Ghinescu-Lucian/Licenta/Imagini/MPU6050_schematics.png

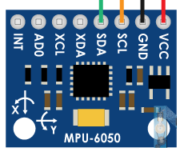
Imagini/MPU6050_schematics.png
