Ghinescu-Lucian/Licenta/Imagini/Testare_Fin.png

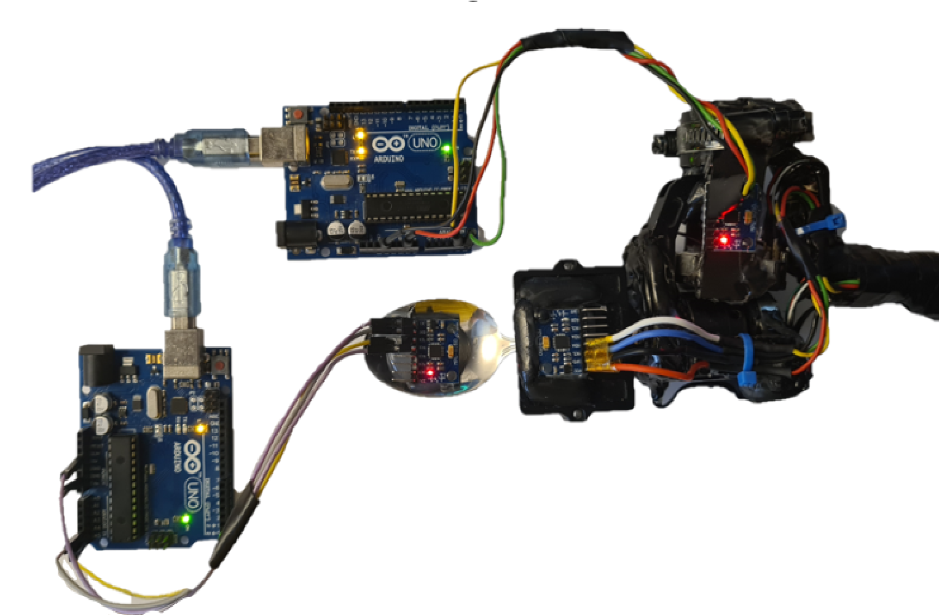
Imagini/Testare_Fin.png
