Ghinescu-Lucian/Licenta/Scheme/Scheme SimpleFOC.docx

12V

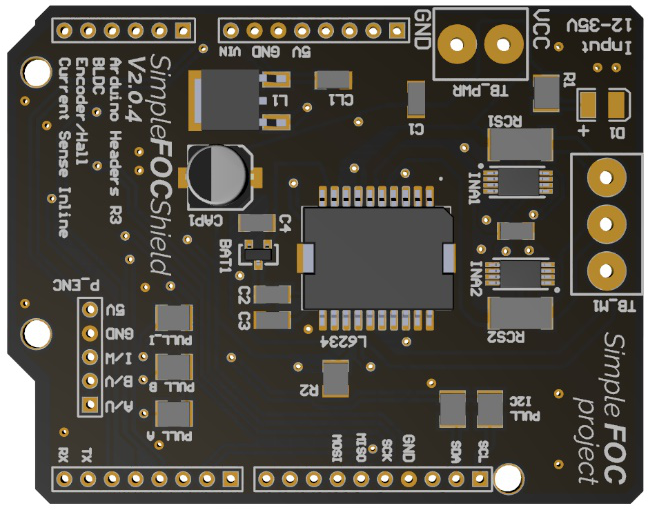
[picture p3: figure]
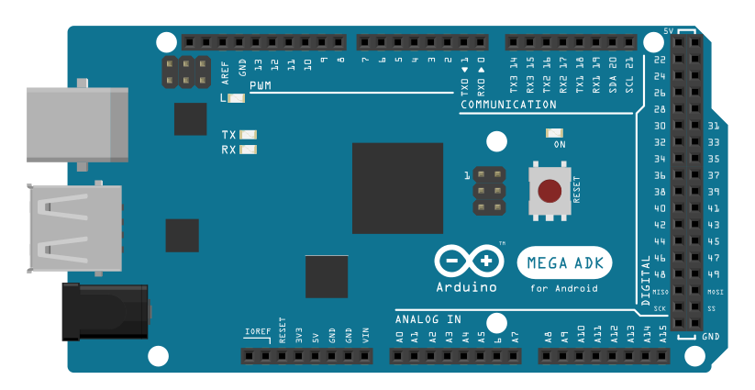
[picture p4: figure]

L1

L2

L3

L1 L2 L3

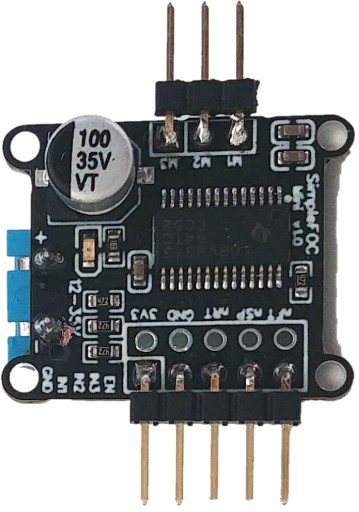
[picture p5: figure]

12V

GND P1 P2 P3 EN
