Ghinescu-Lucian/Licenta/Arduino/Metoda ziegler.docx

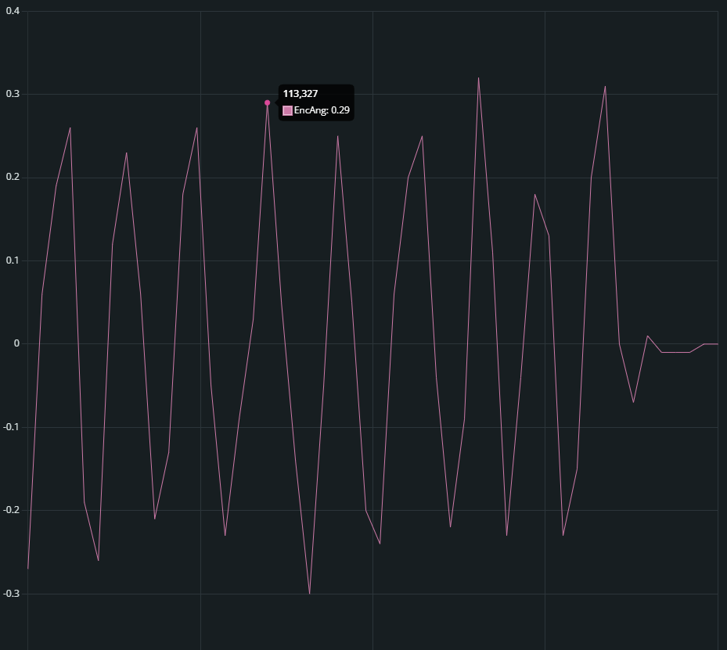
[picture p59: figure]
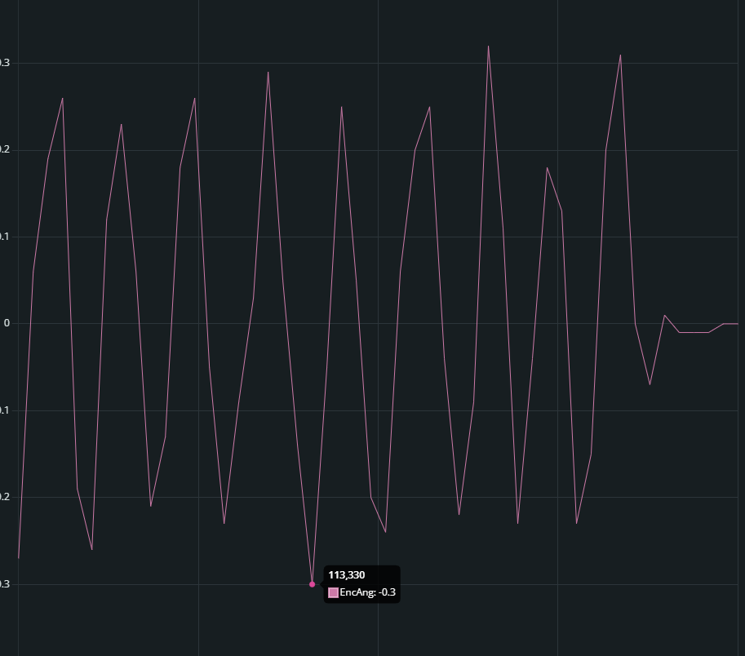
[picture p60: figure]
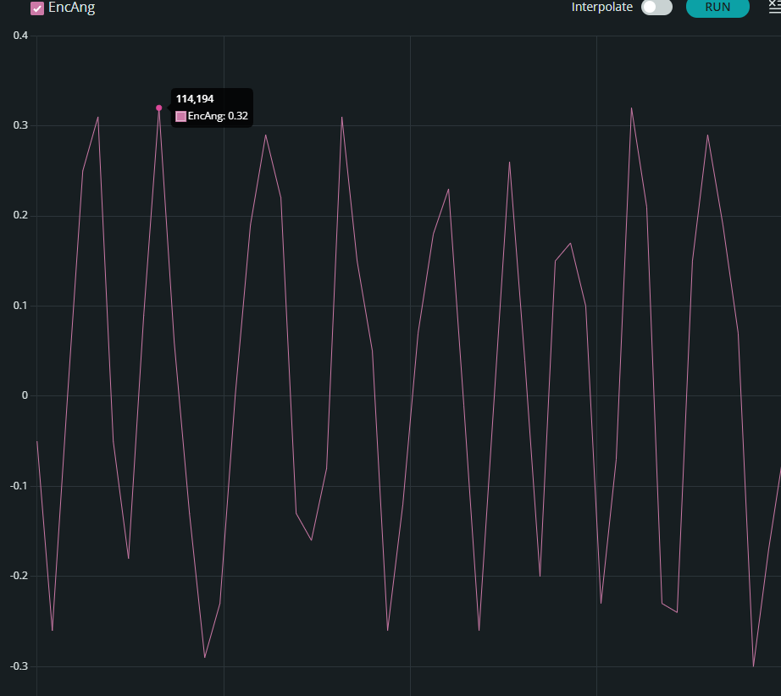
[picture p61: figure]
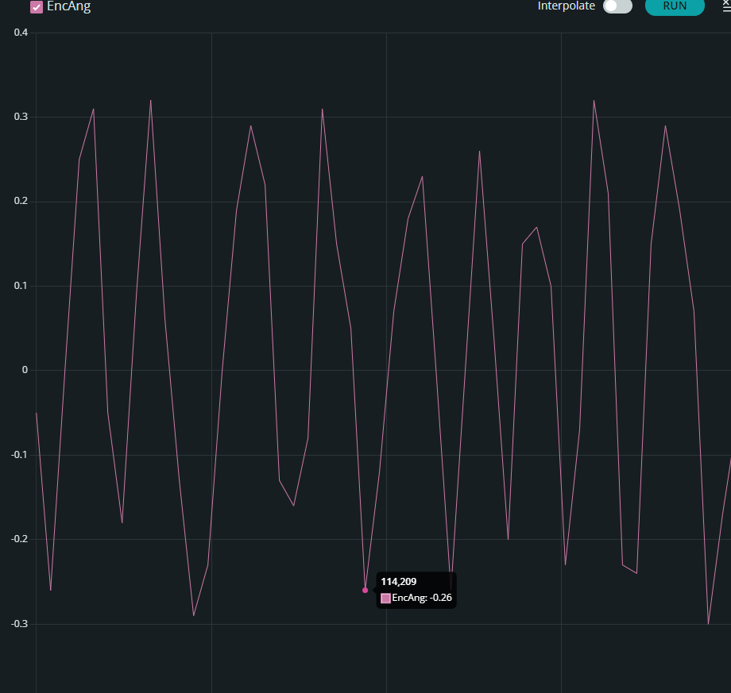
[picture p62: figure]

z

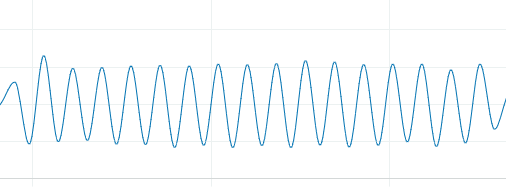
[picture p63: figure]
