Ghinescu-Lucian/Licenta/Arduino/Eroare calcul unghi Motor 1.docx

Eroare calcul unghi

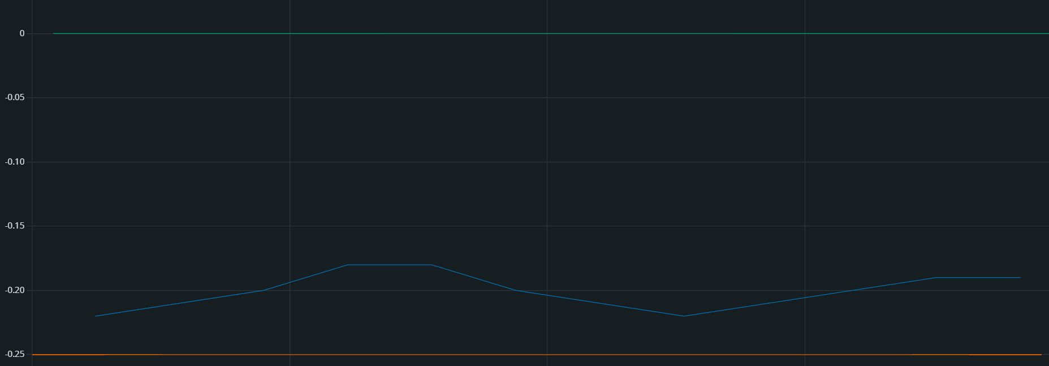
[picture p64: figure]
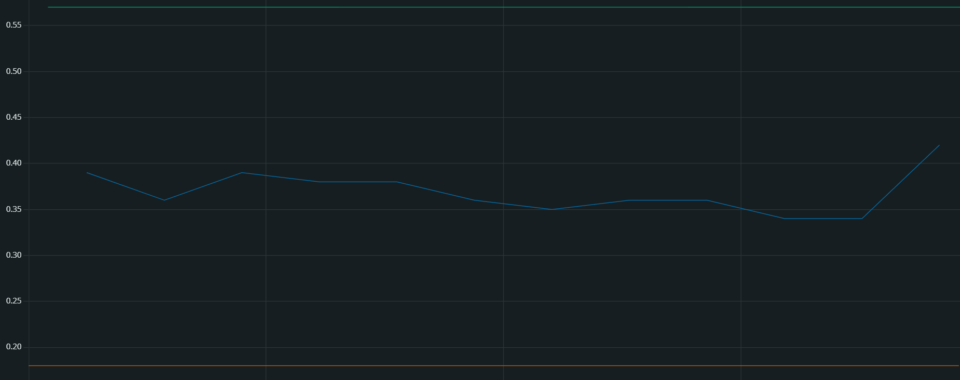
[picture p65: figure]
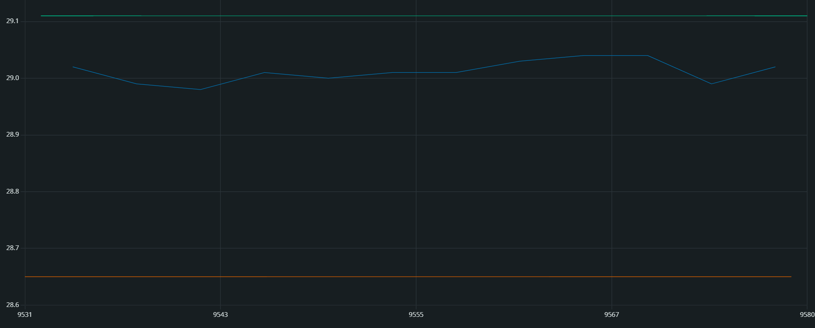
[picture p66: figure]
