Ghinescu-Lucian/Licenta/Arduino/ScreenShots.docx

GetAllData

Orizontal:

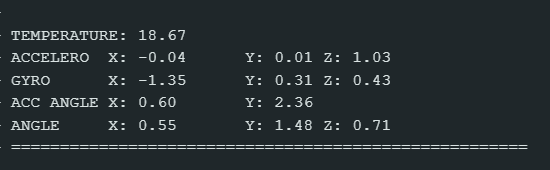
[picture p67: figure]
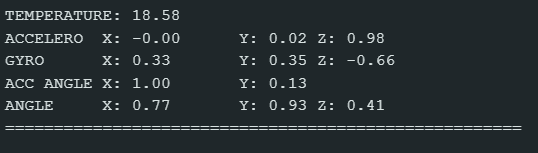
[picture p68: figure]
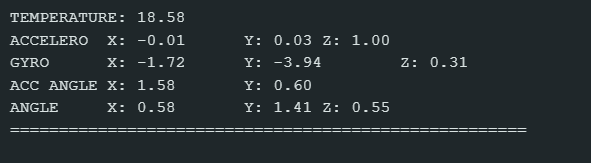
[picture p69: figure]
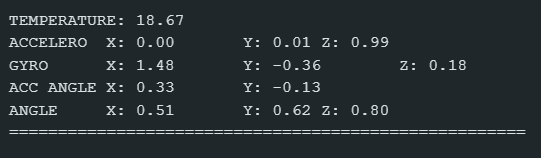
[picture p70: figure]

Rotit pozitiv pe Ox:
