Ghinescu-Lucian/Licenta/Arduino/SS2.docx

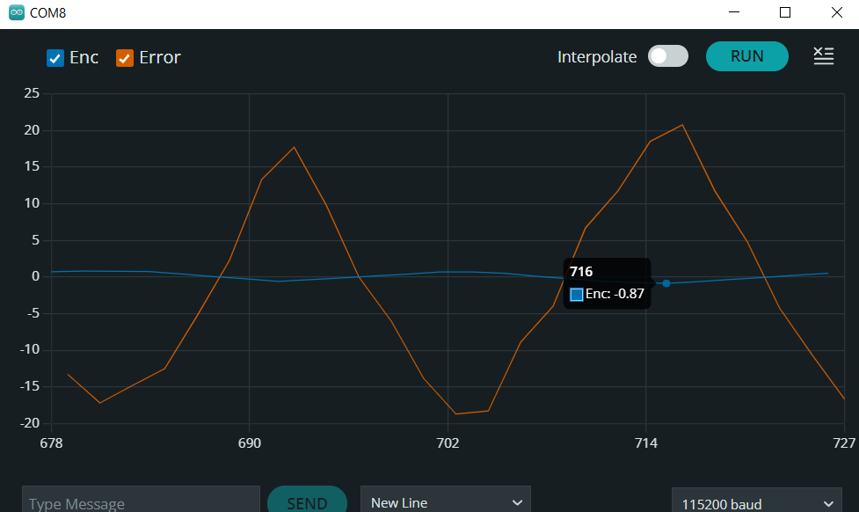
[picture p71: figure]
