Ghinescu-Lucian/Licenta/Imagini/20230531_155205.jpg

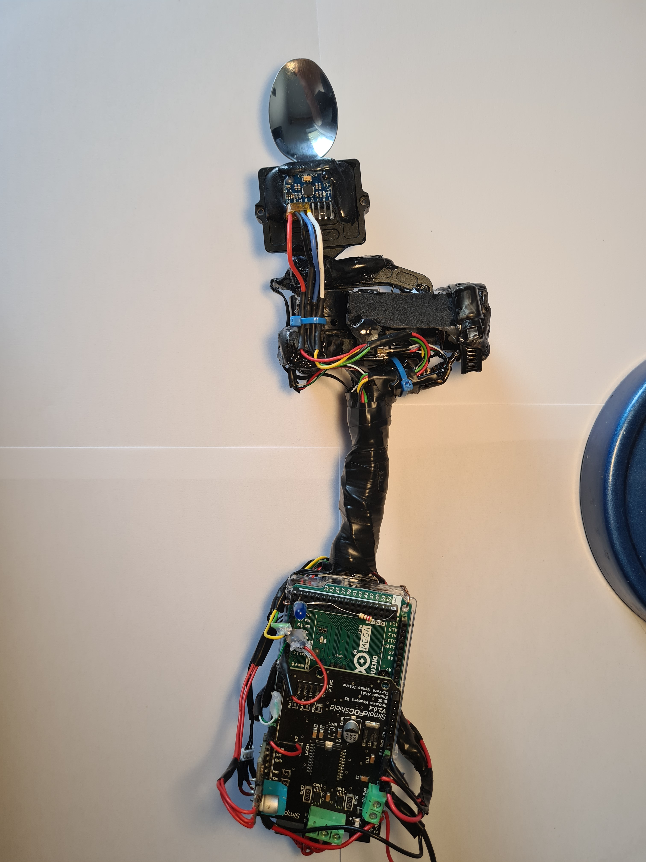
Imagini/20230531_155205.jpg
