Ghinescu-Lucian/Licenta/Imagini/20230531_160016.jpg

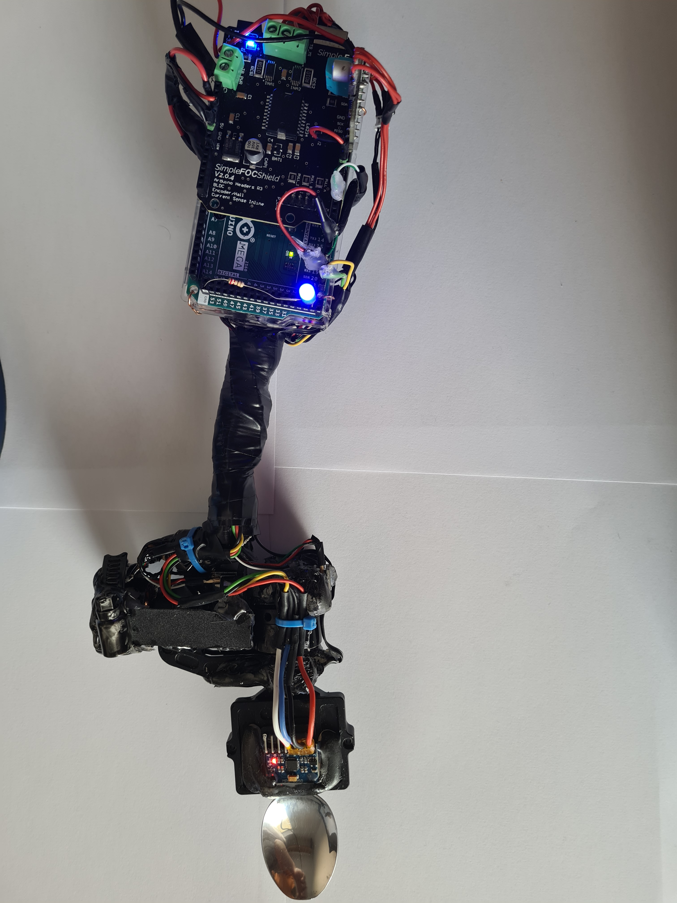
Imagini/20230531_160016.jpg
