Ghinescu-Lucian/Licenta/Imagini/20230531_160238.jpg

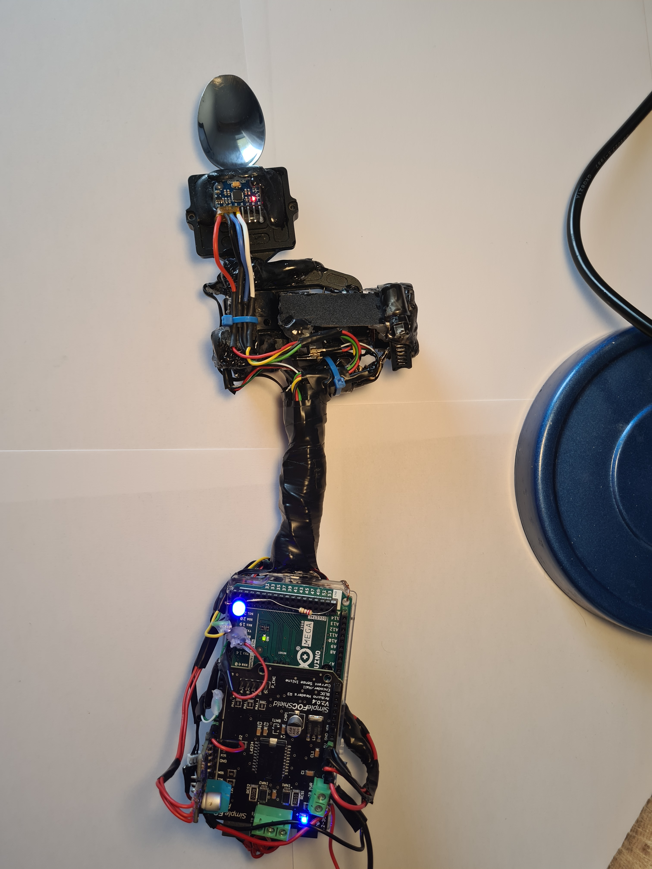
Imagini/20230531_160238.jpg
