Ghinescu-Lucian/Licenta/Imagini/20230531_161017.jpg

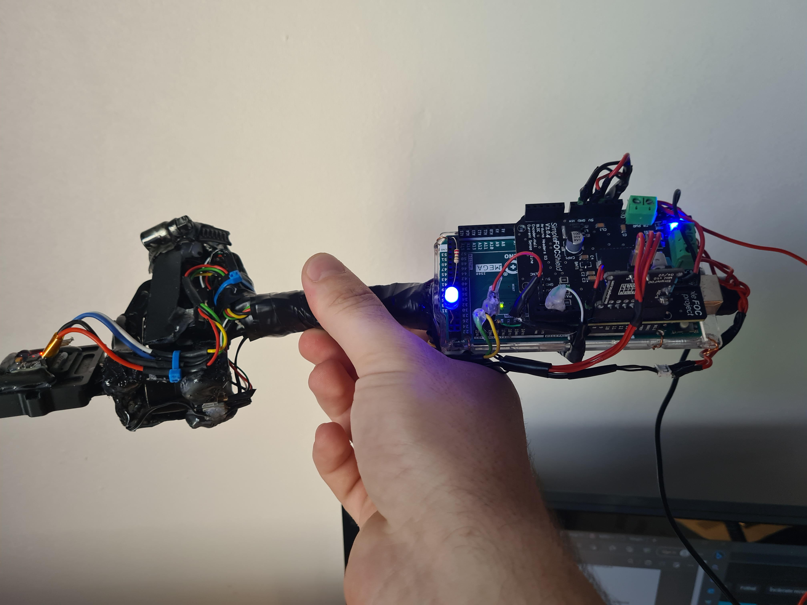
Imagini/20230531_161017.jpg
