Ghinescu-Lucian/Licenta/Imagini/20230531_161514.jpg

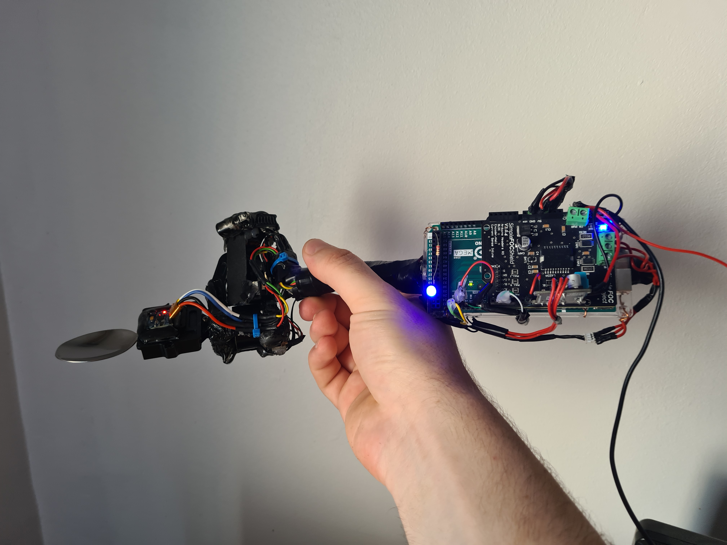
Imagini/20230531_161514.jpg
