Ghinescu-Lucian/Licenta/Imagini/20230611_162131.jpg

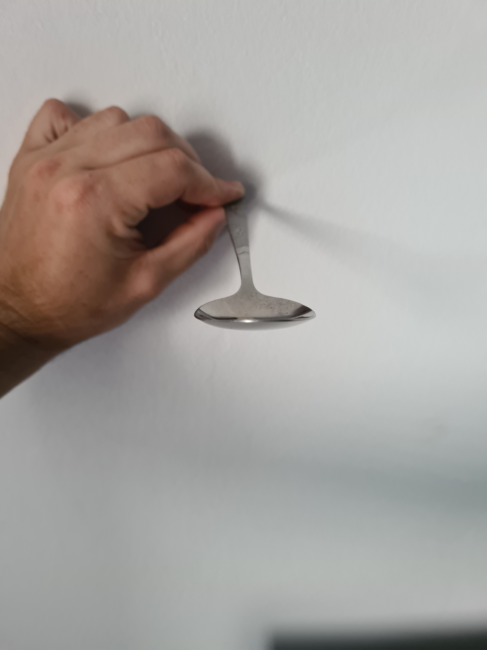
Imagini/20230611_162131.jpg
