Ghinescu-Lucian/Licenta/Imagini/20230611_182041.jpg

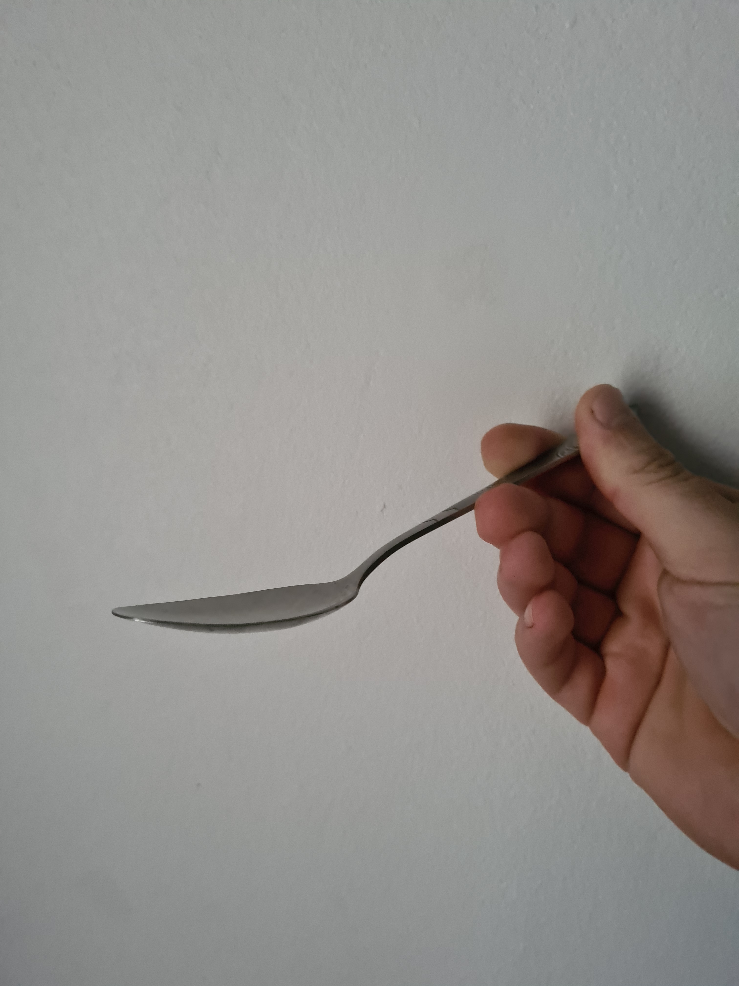
Imagini/20230611_182041.jpg
