Ghinescu-Lucian/Licenta/Imagini/20230612_202844.jpg

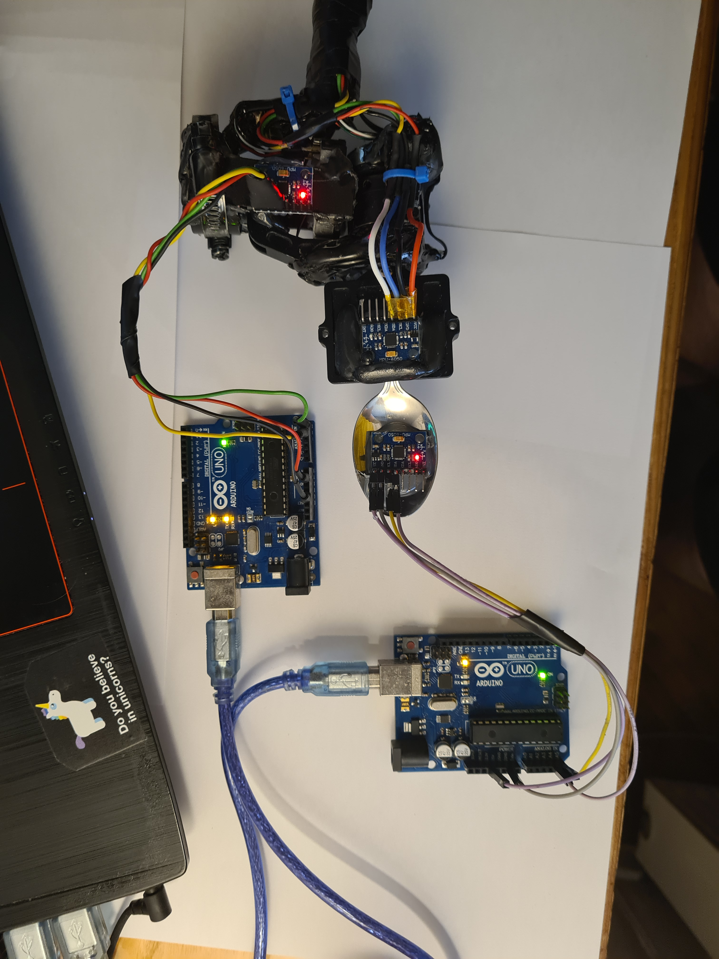
Imagini/20230612_202844.jpg
