Ghinescu-Lucian/Licenta/Imagini/amt103_PNG.png

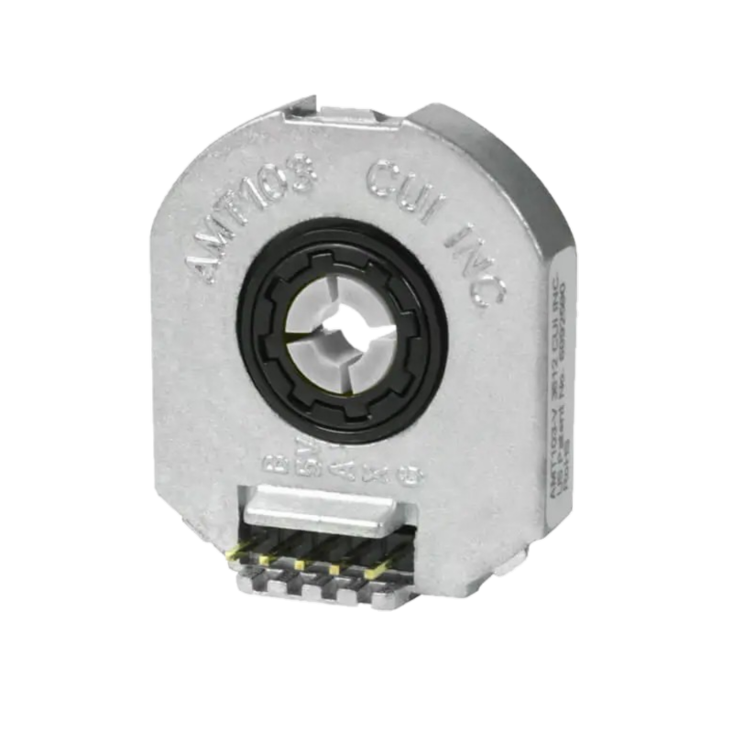
Imagini/amt103_PNG.png
