Ghinescu-Lucian/Licenta/Imagini/AMT303-V.jpg

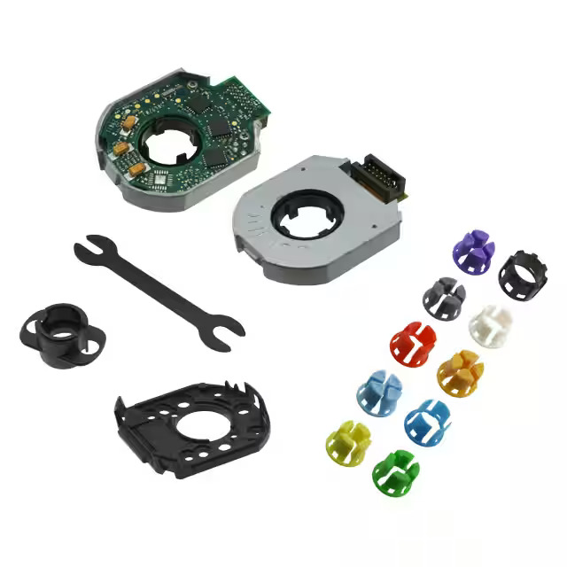
Imagini/AMT303-V.jpg
