Ghinescu-Lucian/Licenta/Imagini/arduino-mega-pin.png

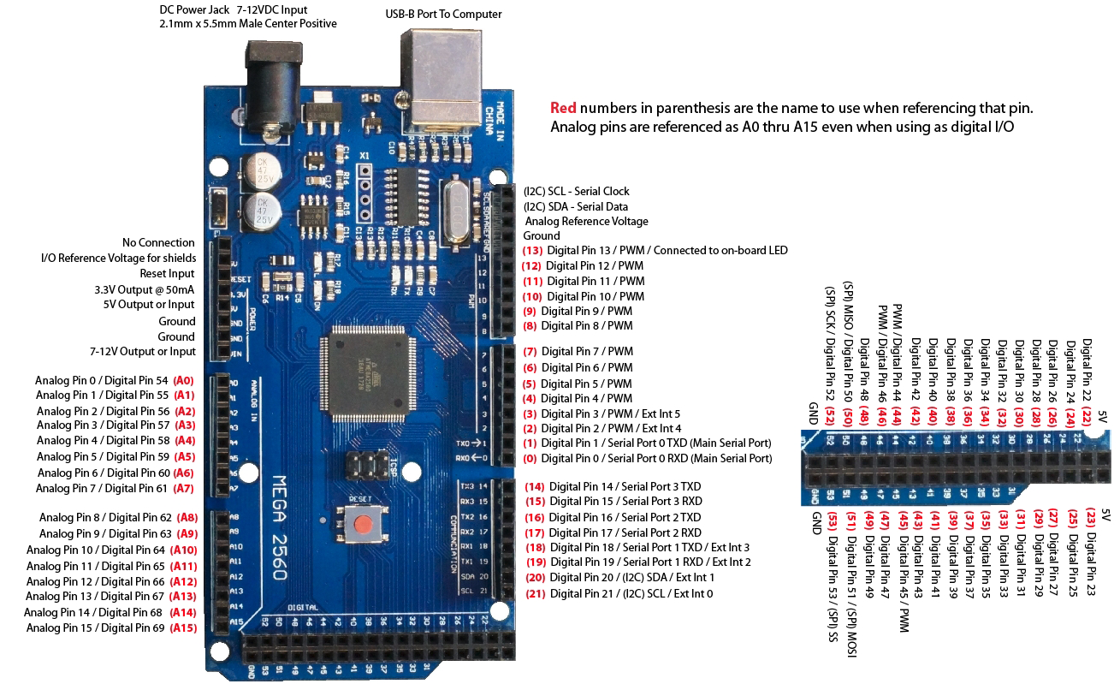
Imagini/arduino-mega-pin.png
