Ghinescu-Lucian/Licenta/Imagini/Axe.png

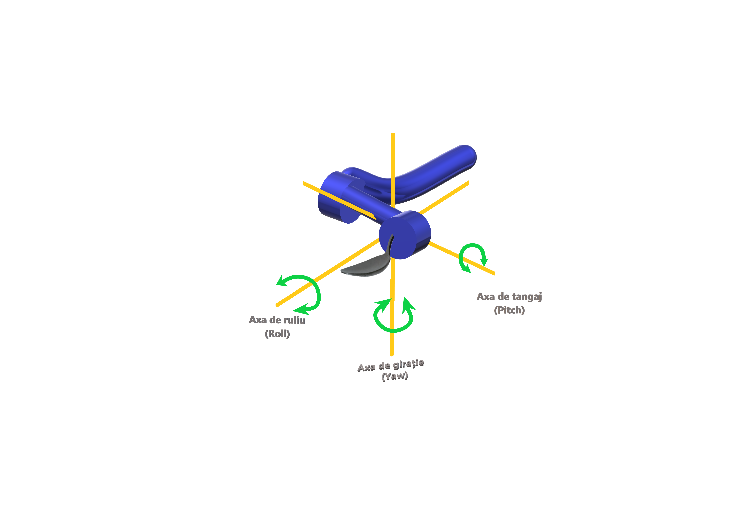
Imagini/Axe.png
