Ghinescu-Lucian/Licenta/Imagini/chip.png

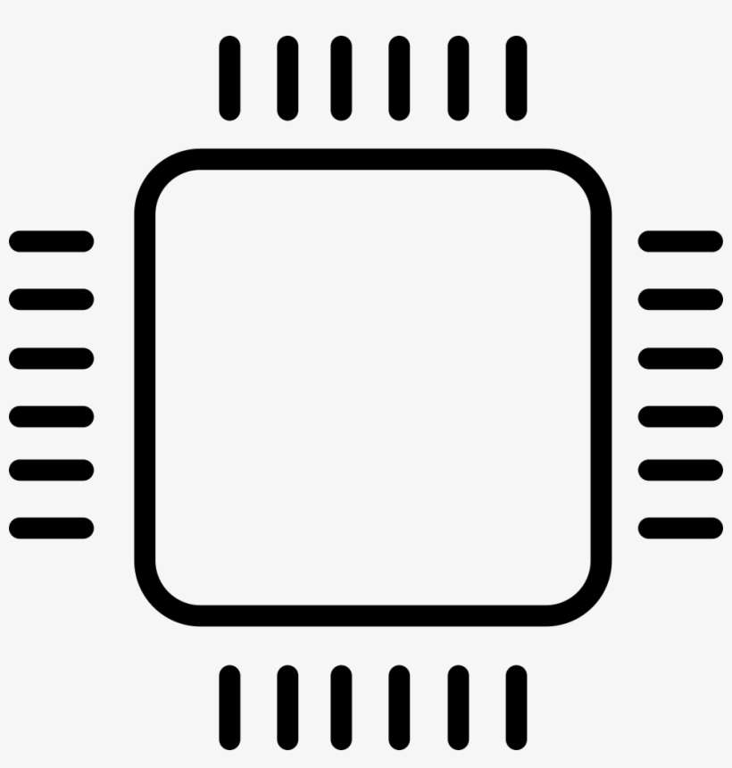
Imagini/chip.png
