Ghinescu-Lucian/Licenta/Imagini/chipArduino.png

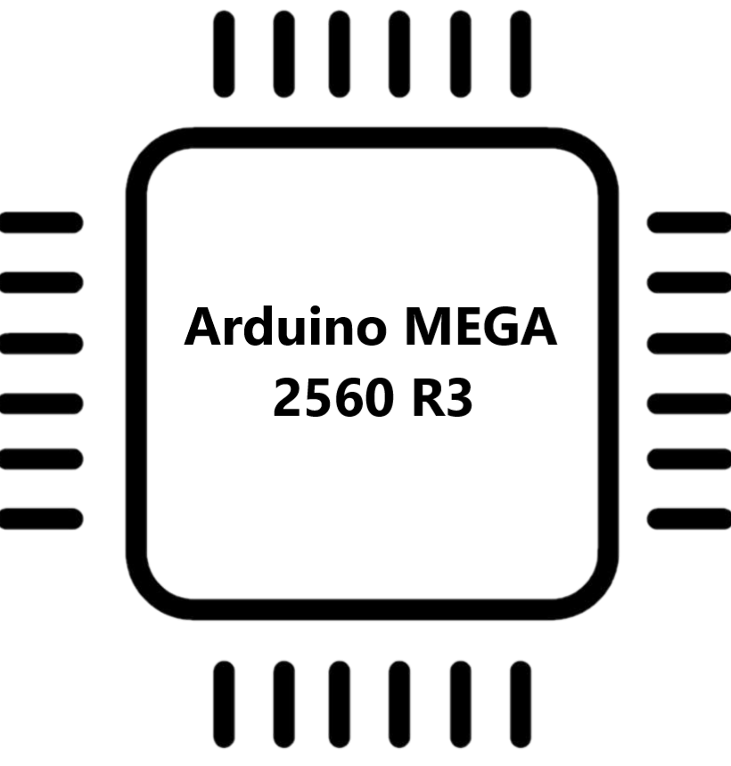
Imagini/chipArduino.png
