Ghinescu-Lucian/Licenta/Imagini/CUI_AMT103.jpg

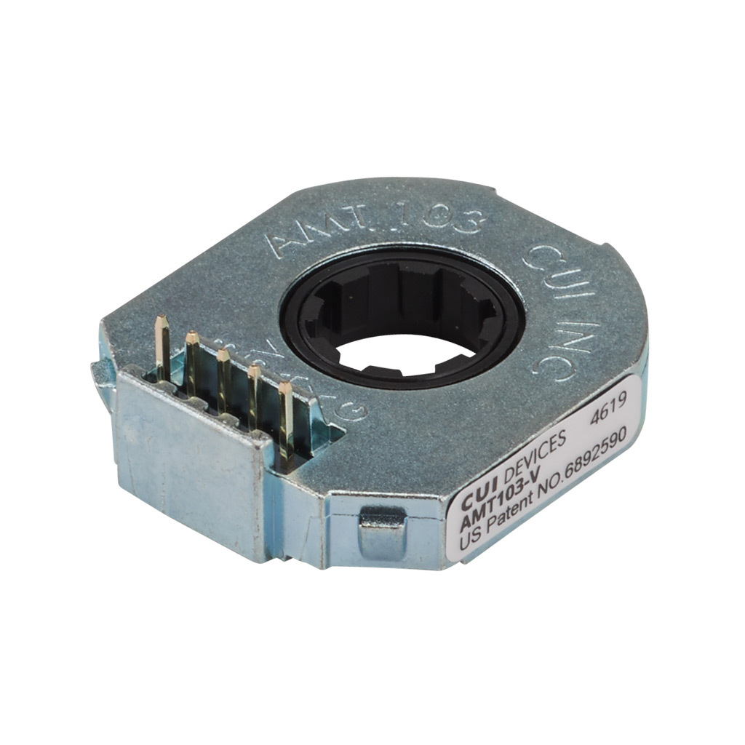
Imagini/CUI_AMT103.jpg
