Ghinescu-Lucian/Licenta/Imagini/driverFOC_PNG.png

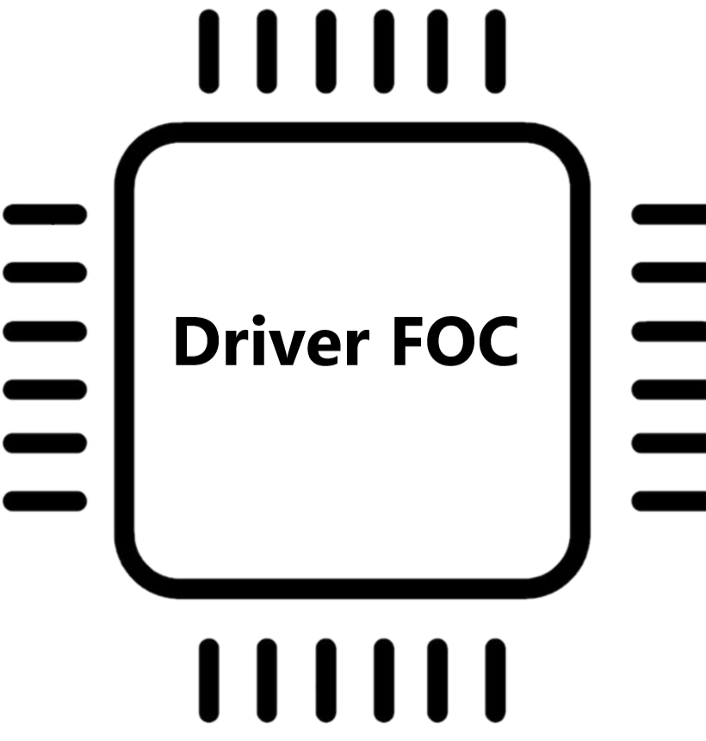
Imagini/driverFOC_PNG.png
