Ghinescu-Lucian/Licenta/Imagini/Licenta profil.png

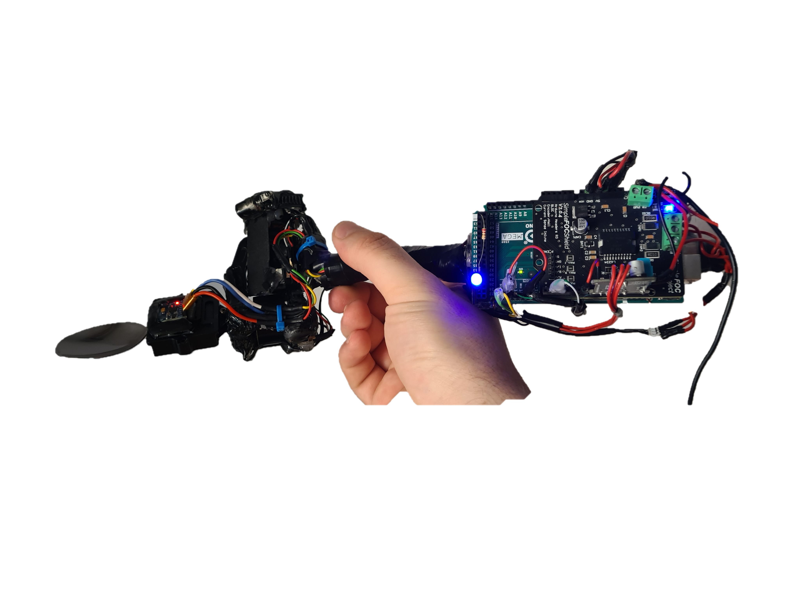
Imagini/Licenta profil.png
