Ghinescu-Lucian/Licenta/Imagini/Licenta_Sus.png

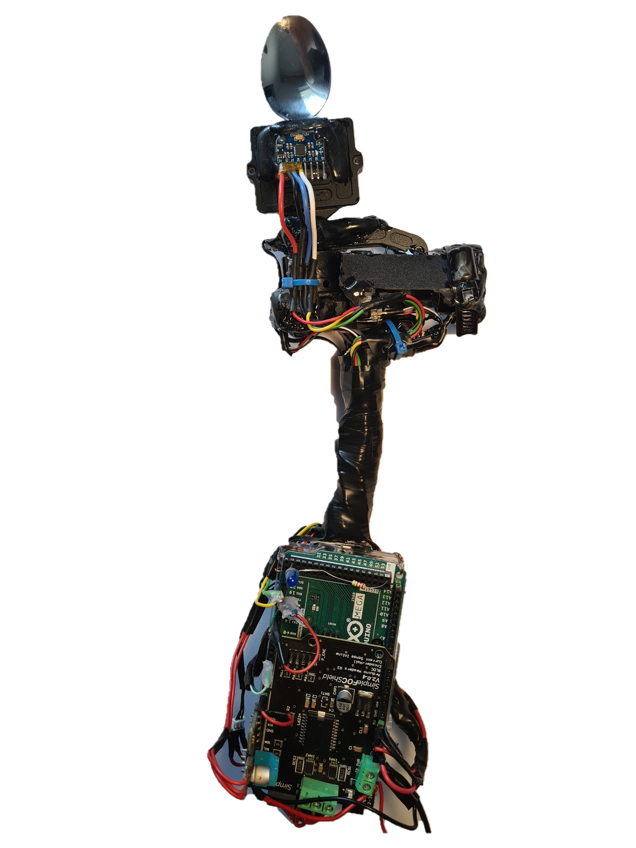
Imagini/Licenta_Sus.png
