Ghinescu-Lucian/Licenta/Imagini/Lingura.jpg

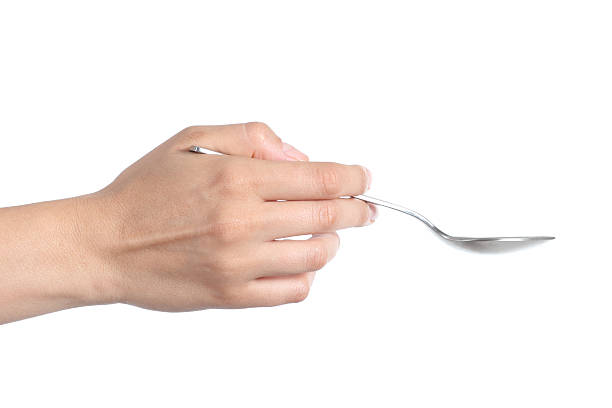
Imagini/Lingura.jpg
