Ghinescu-Lucian/Licenta/Imagini/MiniFOC_png.png

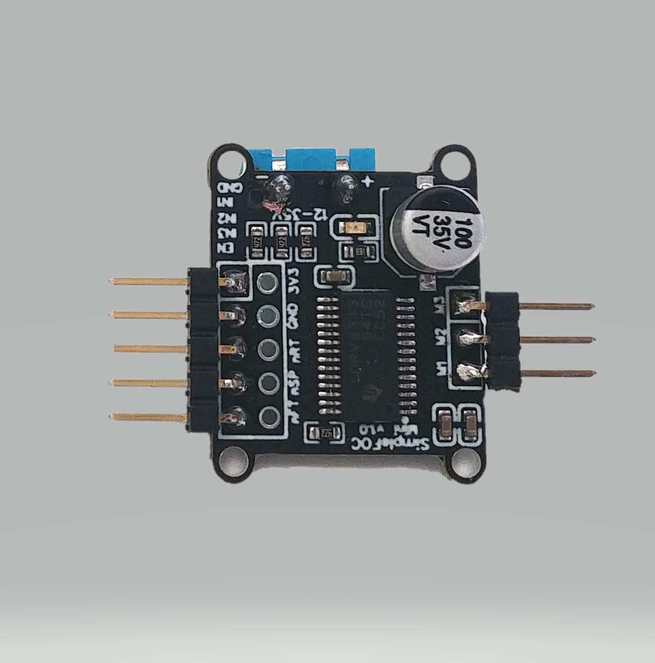
Imagini/MiniFOC_png.png
