Ghinescu-Lucian/Licenta/Imagini/Motor_PNG.png

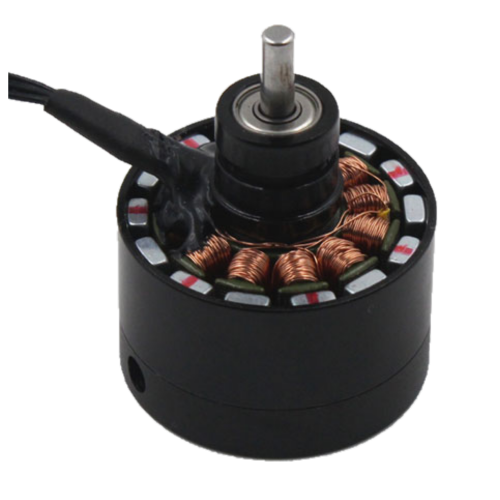
Imagini/Motor_PNG.png
