Ghinescu-Lucian/Licenta/Imagini/MPU6050_Light.png

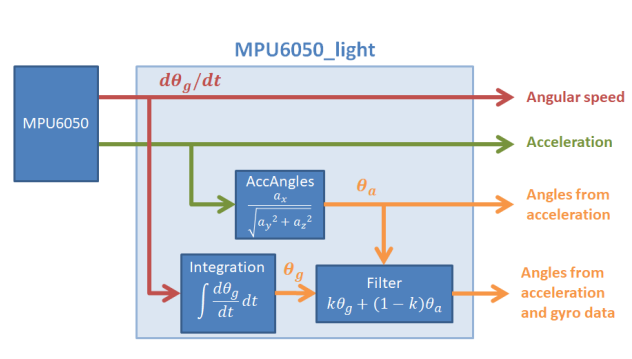
Imagini/MPU6050_Light.png
