Ghinescu-Lucian/Licenta/Imagini/mpu_error.png

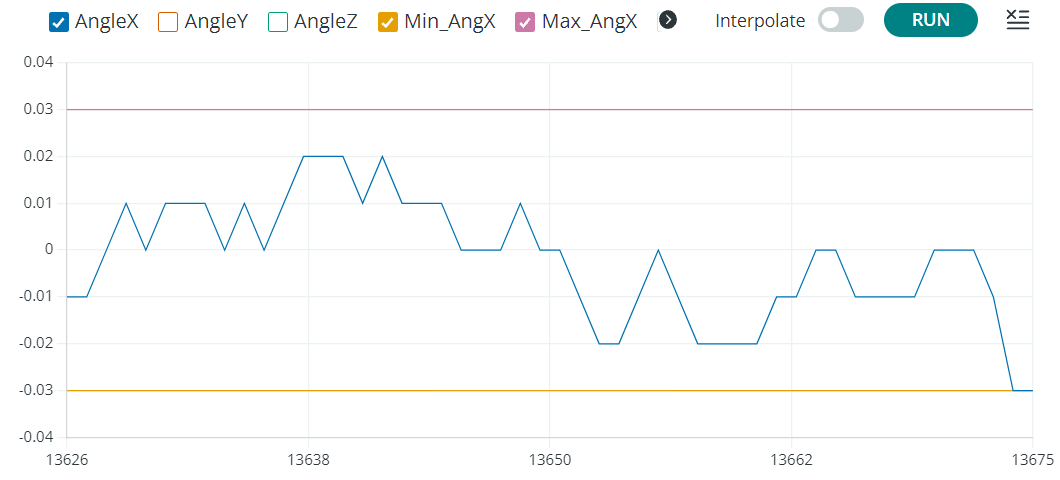
Imagini/mpu_error.png
