Ghinescu-Lucian/Licenta/Imagini/mpu_errorPithc.png

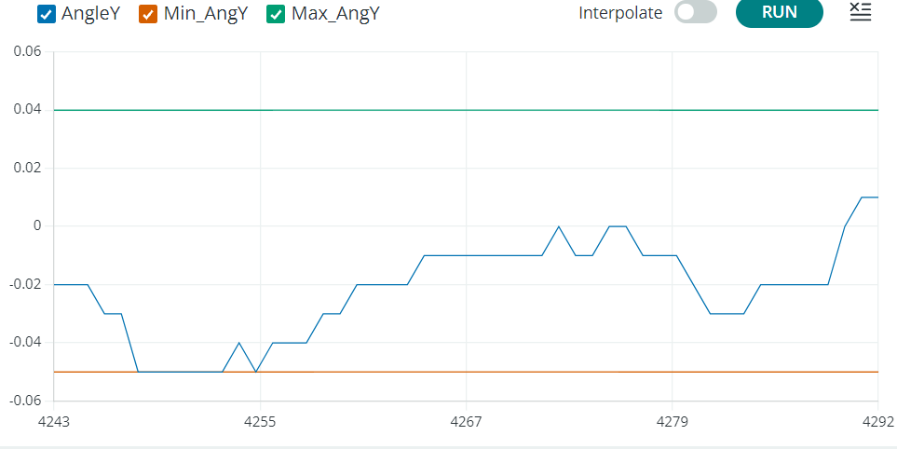
Imagini/mpu_errorPithc.png
