Ghinescu-Lucian/Licenta/Imagini/MPU_SCH_BUN.png

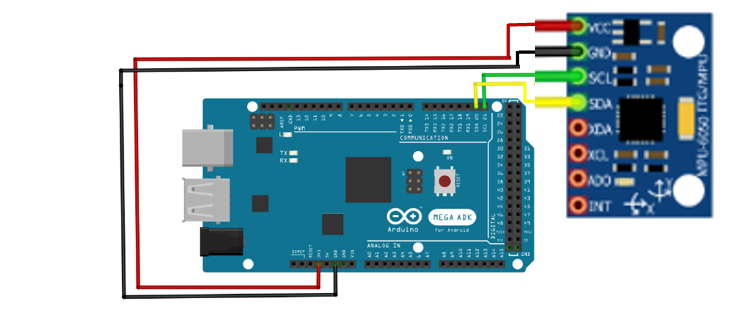
Imagini/MPU_SCH_BUN.png
