Ghinescu-Lucian/Licenta/Imagini/Proces_Stabilizare.png

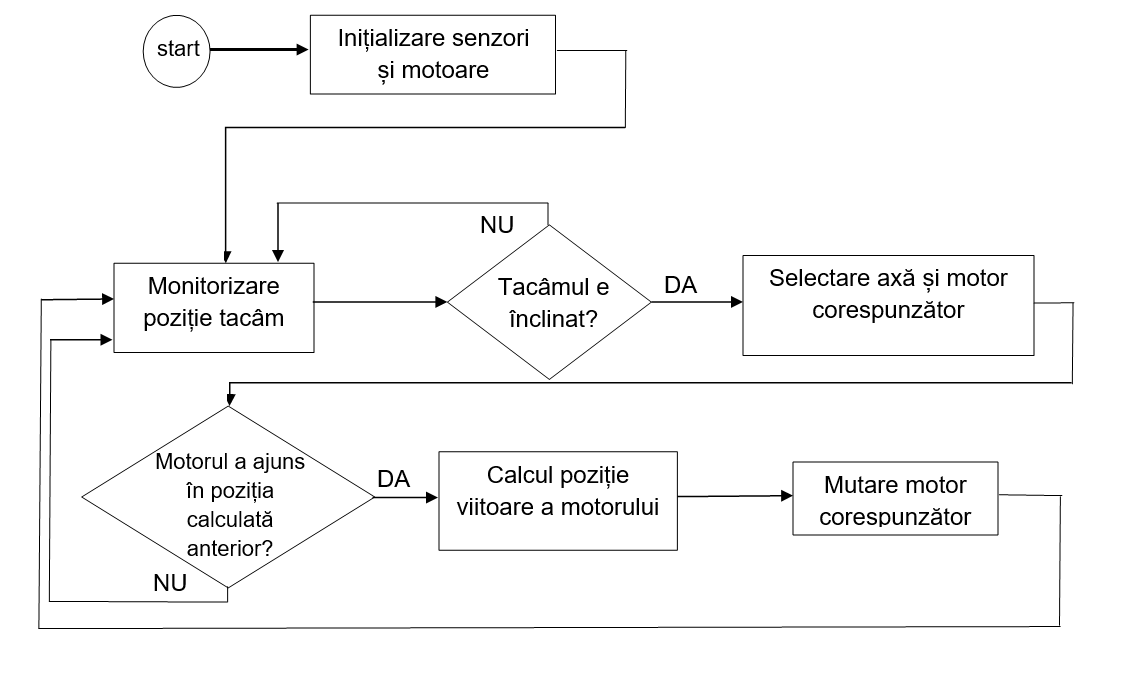
Imagini/Proces_Stabilizare.png
