Ghinescu-Lucian/Licenta/Imagini/Profil_v2.png

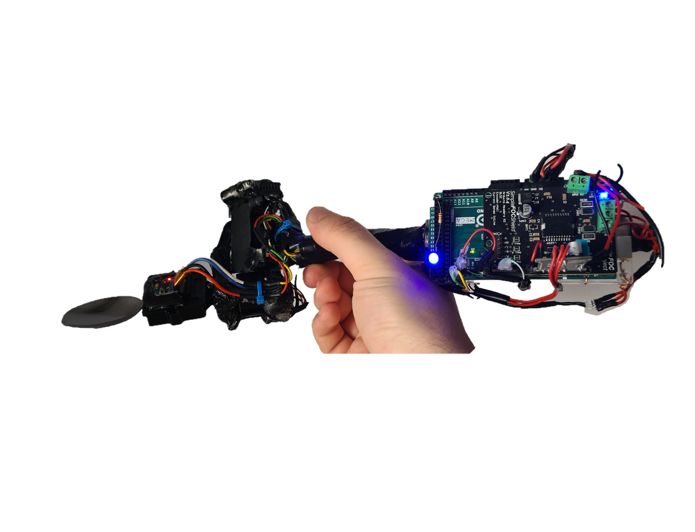
Imagini/Profil_v2.png
