Ghinescu-Lucian/Licenta/Imagini/Ruliu_compensat.png

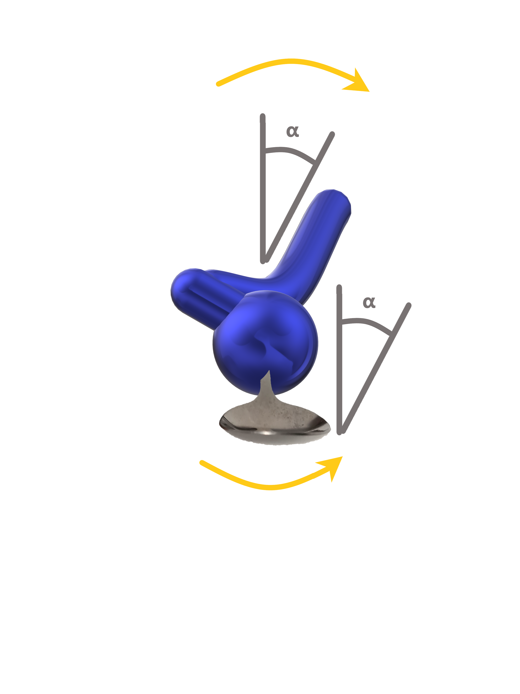
Imagini/Ruliu_compensat.png
