Ghinescu-Lucian/Licenta/Imagini/Ruliu_necompensat.png

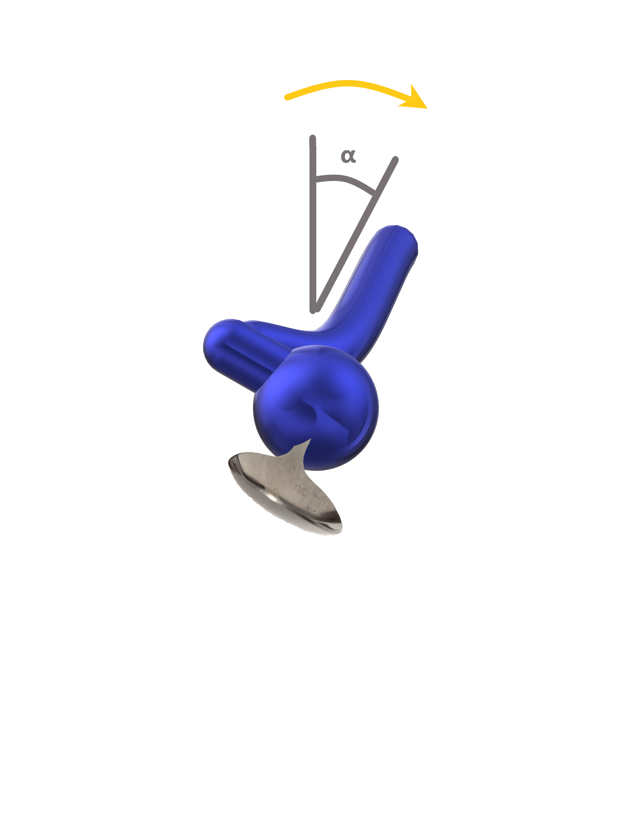
Imagini/Ruliu_necompensat.png
