Ghinescu-Lucian/Licenta/Imagini/Schema_Algoritm.png

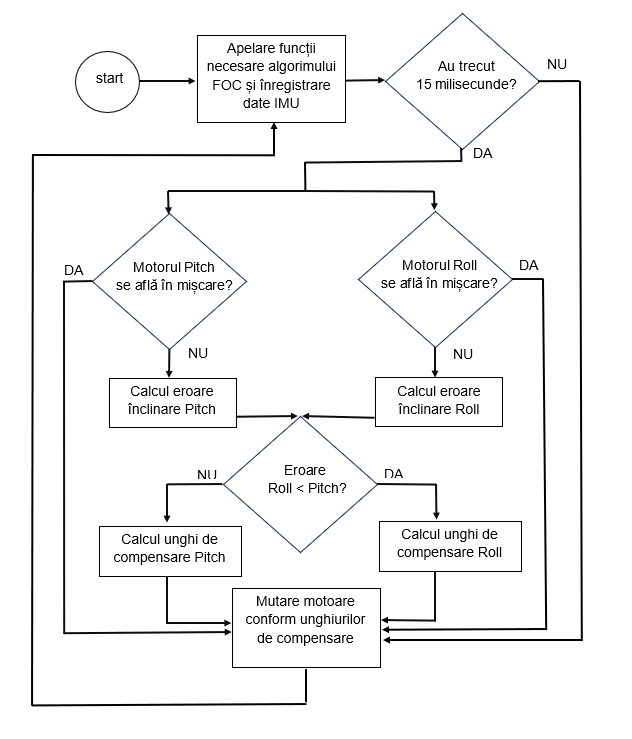
Imagini/Schema_Algoritm.png
