Ghinescu-Lucian/Licenta/Imagini/simpleFOC_mini.jpg

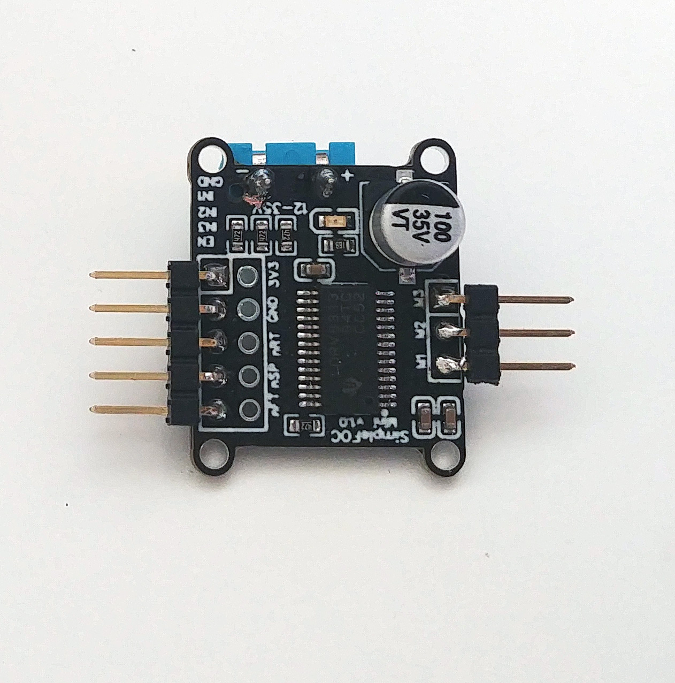
Imagini/simpleFOC_mini.jpg
