Ghinescu-Lucian/Licenta/Imagini/spoon2.webp

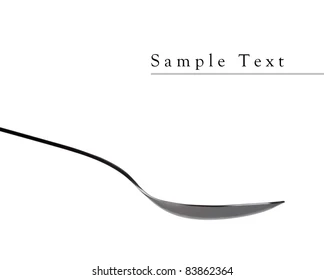
Imagini/spoon2.webp
