Ghinescu-Lucian/Licenta/Imagini/spoon3.jpg

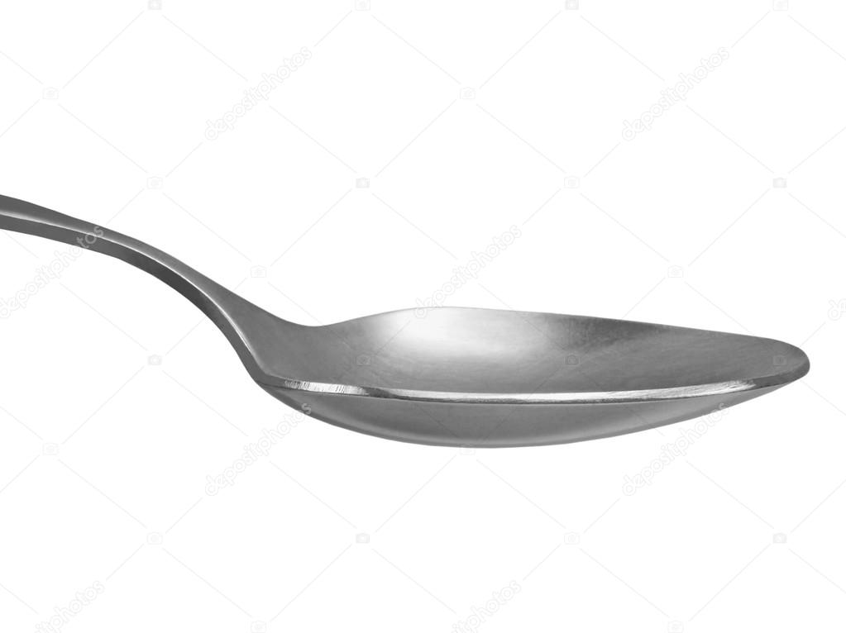
Imagini/spoon3.jpg
