Ghinescu-Lucian/Licenta/Imagini/Tangaj_Compensat.png

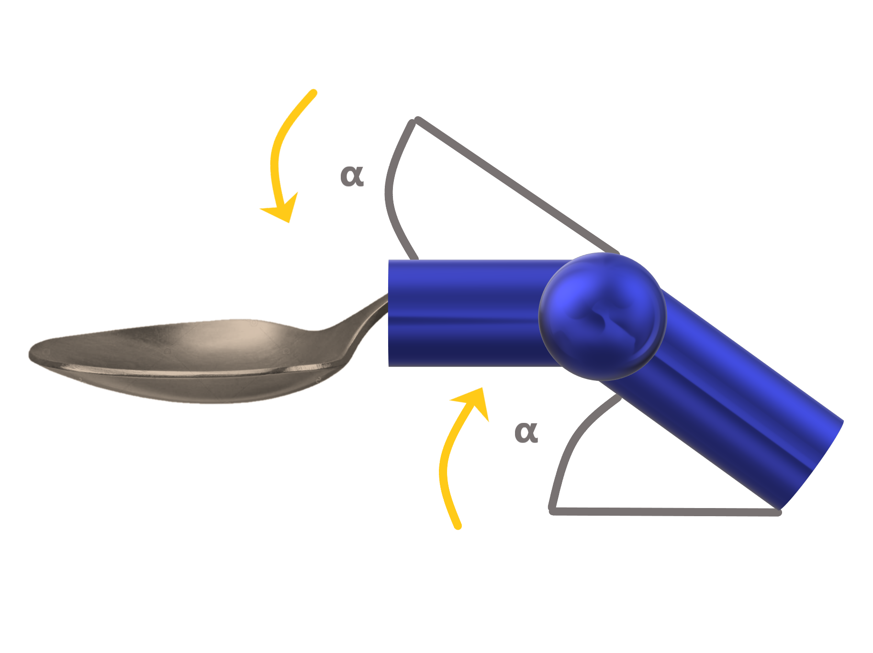
Imagini/Tangaj_Compensat.png
