Ghinescu-Lucian/Licenta/Imagini/Tangaj_necompensat.png

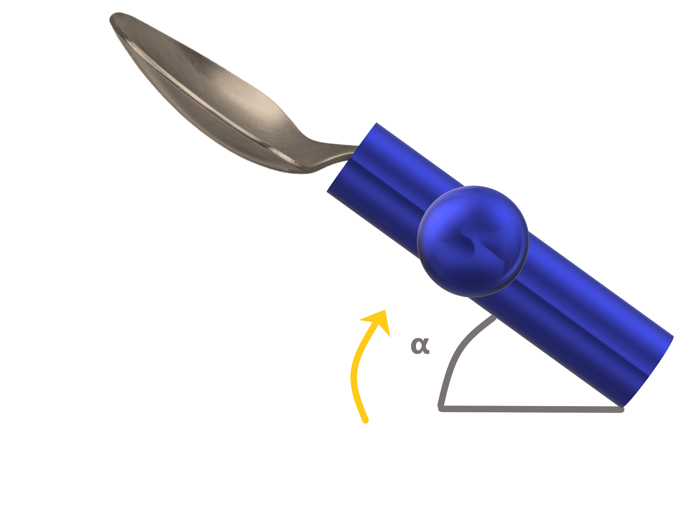
Imagini/Tangaj_necompensat.png
