Ghinescu-Lucian/Licenta/Scheme/SimpleFOCShield_SCH.png

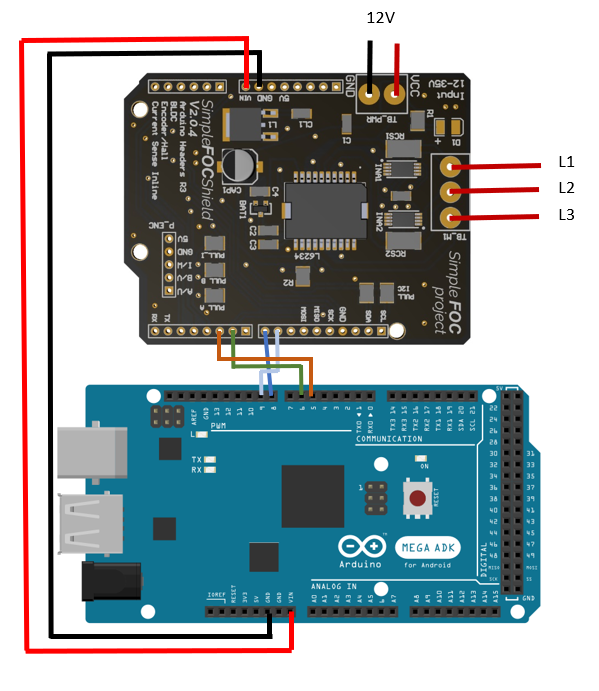
Scheme/SimpleFOCShield_SCH.png
