Ghinescu-Lucian/Licenta/Arduino/Testare/Masuratori-Test2.xlsx

Sheet: UNO1_ROLL
Time | Roll
0:01:22 | -6.532 | 1.15
0:01:22 | -5.4165
0:01:22 | -4.485
0:01:22 | -3.7145
0:01:22 | -3.0705
0:01:22 | -2.53
0:01:22 | -2.0585
0:01:22 | -1.7135
0:01:22 | -1.403
0:01:22 | -1.242
0:01:22 | -1.035
0:01:22 | -0.8625
0:01:22 | -0.713
0:01:23 | 0.161
0:01:23 | 0.345
0:01:23 | 0.529
0:01:23 | 0.4025
0:01:23 | 0.3335
0:01:23 | 0.276
0:01:23 | 0.2415
0:01:23 | 0.1955
0:01:23 | 0.161
0:01:23 | 0.1265
0:01:23 | 0.1265
0:01:23 | 0.1035
0:01:23 | 0.092
0:01:23 | 0.092
0:01:23 | 0.0805
0:01:23 | 0.092
0:01:23 | 0.069
0:01:23 | 0.069
0:01:23 | 0.069
0:01:23 | 0.069
0:01:24 | 0.0575
0:01:24 | 0.0575
0:01:24 | 0.046
0:01:24 | 0.046
0:01:24 | 0.046
0:01:24 | 0.046
0:01:24 | 0.046
0:01:24 | 0.023
0:01:24 | 0.0115
0:01:24 | 0
0:01:24 | -0.0115
0:01:24 | -0.023
0:01:24 | -0.0115
0:01:24 | -0.0115
0:01:24 | -0.0115
0:01:24 | 0
0:01:24 | 0
0:01:24 | 0
0:01:24 | -0.0115
0:01:24 | 0
0:01:24 | 0
0:01:25 | 0
0:01:25 | -0.0115
0:01:25 | 0.0115
0:01:25 | 0.0115
0:01:25 | 0.023
0:01:25 | 0.023
0:01:25 | 0.023
0:01:25 | 0.0345
0:01:25 | 0.0345
0:01:25 | 0.0345
0:01:25 | 0.0345
0:01:25 | 0.0345
0:01:25 | 0.0345
0:01:25 | 0.0345
0:01:25 | 0.0345
0:01:25 | 0.0345
0:01:25 | 0.023
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
