Ghinescu-Lucian/Licenta/Arduino/Testare/Masuratori_Test1.xlsx

Sheet: UNO1_Pitch
Time | Pitch
19:41:20 | 13.21
19:41:20 | 10.92
19:41:20 | 9.02
19:41:20 | 7.46
19:41:20 | 6.16
19:41:20 | 5.09
19:41:20 | 4.27
19:41:21 | 3.53
19:41:21 | 2.92
19:41:21 | 2.44
19:41:21 | 2
19:41:21 | 1.58
19:41:21 | 1.31
19:41:21 | 1.08
19:41:21 | 0.89
19:41:21 | 0.74
19:41:21 | 0.61
19:41:21 | 0.54
19:41:21 | 0.45
19:41:21 | 0.37
19:41:21 | 0.3
19:41:21 | 0.24
19:41:21 | 0.18
19:41:21 | 0.14
19:41:21 | 0.12
19:41:21 | 0.1
19:41:22 | 0.08
19:41:22 | 0.06
19:41:22 | 0.06
19:41:22 | 0.05
19:41:22 | 0.06
19:41:22 | 0.05
19:41:22 | 0.06
19:41:22 | 0.04
19:41:22 | 0.03
19:41:22 | 0.03
19:41:22 | 0.02
19:41:22 | 0.02
19:41:22 | 0.01
19:41:22 | 0
19:41:22 | 0.01
19:41:22 | 0.01
19:41:22 | 0.01
19:41:22 | 0.01
19:41:22 | 0
19:41:22 | 0.01
19:41:23 | 0.01
19:41:23 | 0.01
19:41:23 | 0.01
19:41:23 | 0.01
19:41:23 | 0.01
19:41:23 | 0.01
19:41:23 | 0.01
19:41:23 | 0.01
19:41:23 | 0.01
19:41:23 | 0.01
19:41:23 | 0.01
19:41:23 | 0.01
19:41:23 | 0.01
19:41:23 | 0.01
19:41:23 | -0.01
19:41:23 | 0
19:41:23 | 0
19:41:23 | 0.01
19:41:23 | 0.01
19:41:23 | 0.01
19:41:24 | 0
19:41:24 | 0
19:41:24 | 0
19:41:24 | -0.01
19:41:24 | 0
19:41:24 | 0.01
19:41:24 | 0
19:41:24 | 0
19:41:24 | 0
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
