Ghinescu-Lucian/Licenta/Imagini/Rezultate_Test1.png

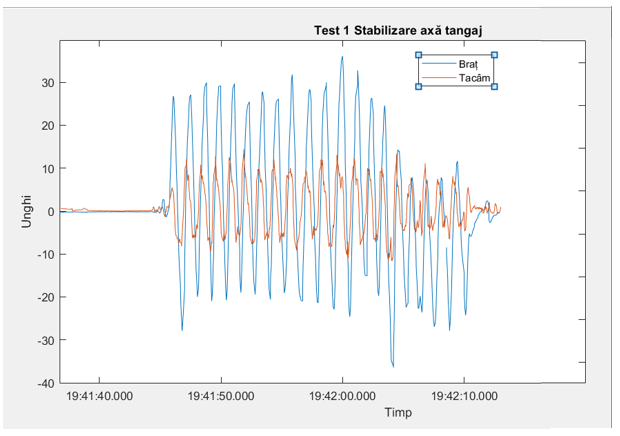
Imagini/Rezultate_Test1.png
