Ghinescu-Lucian/Licenta/Imagini/Testare_final.png

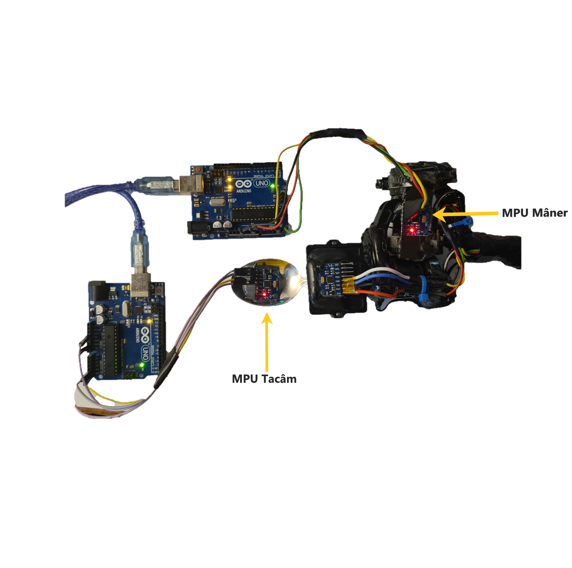
Imagini/Testare_final.png
