Ghinescu-Lucian/Licenta/(list of files, drawings)

Other design files:
Scheme/AMT103V.fzz
Scheme/MPU-6050 Board GY-521 Acelerometro Giroscopio.fzz
