Ghinescu-Lucian/Licenta/Arduino/FinalCode/FinalCode.ino

/*
MUTARE DE PE GYRO PE ACC
AHRS ATITUDE AND REF SYSTEM


**/
#include <SimpleFOC.h>
#include "Wire.h"
#include <MPU6050_light.h>

MPU6050 mpu(Wire);
BLDCMotor motor = BLDCMotor(7);
BLDCDriver3PWM driver = BLDCDriver3PWM(9, 5, 6, 8);
BLDCMotor motor2 = BLDCMotor(7);
BLDCDriver3PWM driver2 = BLDCDriver3PWM(10, 11, 12, 7);

double Input_roll, Setpoint_roll;
double Input_pitch, Setpoint_pitch;


Encoder encoder = Encoder(18, 19, 2048);
Encoder encoder2 = Encoder(2, 3, 2048);
// interrupt routine intialisation
void doA() {
  encoder.handleA();
}
void doB() {
  encoder.handleB();
}
void doA2() {
  encoder2.handleA();
}
void doB2() {
  encoder2.handleB();
}


Commander command = Commander(Serial);
// motor 1 params

void doTarget_AP(char* cmd) {
  float ap = 0;
  command.scalar(&ap, cmd);
  Serial.println("M AP");
  motor.P_angle.P = ap;
}
void doTarget_AI(char* cmd) {
  float ai = 0;
  command.scalar(&ai, cmd);
  Serial.println("M AI");
  motor.P_angle.I = ai;
}
void doTarget_AD(char* cmd) {
  float ad = 0;
  command.scalar(&ad, cmd);
  Serial.println("M AD");
  motor.P_angle.D = ad;
}
void doTarget_VP(char* cmd) {
  float vp = 0;
  command.scalar(&vp, cmd);
  Serial.println("M VP");
  motor.PID_velocity.P = vp;
}
void doTarget_VI(char* cmd) {
  float vi = 0;
  command.scalar(&vi, cmd);
  Serial.println("M VI");
  motor.PID_velocity.I = vi;
}
void doTarget_VD(char* cmd) {
  float vd = 0;
  command.scalar(&vd, cmd);
  Serial.println("M VD");
  motor.PID_velocity.D = vd;
}

void doTarget_Vramp(char* cmd) {
  float ramp = 0;
  command.scalar(&ramp, cmd);
  Serial.println("V ramp");
  motor.PID_velocity.output_ramp = ramp;
}
void doTarget_Aramp(char* cmd) {
  float aramp = 0;
  command.scalar(&aramp, cmd);
  Serial.println("A ramp");
  motor.P_angle.output_ramp = aramp;
}


void setup() {


  Serial.begin(9600);


  Wire.begin();


  byte status = mpu.begin();
  Serial.print(F("MPU6050 status: "));
  Serial.println(status);
  while (status != 0) {}  // stop everything if could not connect to MPU6050

  Serial.println(F("Calculating offsets, do not move MPU6050"));
  delay(1000);
  mpu.calcOffsets(true, true);  // gyro and accelero
  Serial.println("Done!\n");

  encoder.init();
  // hardware interrupt enable
  encoder.enableInterrupts(doA, doB);
  // link the motor to the sensor
  motor.linkSensor(&encoder);

  // power supply voltage
  // default 12V
  driver.voltage_power_supply = 12;
  driver.init();

  motor.linkDriver(&driver);

  motor.foc_modulation = FOCModulationType::SinePWM;


  // initialize motor
  motor.init();
  // monitoring port
  motor.useMonitoring(Serial);
  // set FOC loop to be used
  motor.controller = MotionControlType::angle;
  //  motor.controller = MotionControlType::angle_openloop;

  motor.PID_velocity.P = 0.2f;  //0.2f;
  motor.PID_velocity.I = 10;
  motor.PID_velocity.D = 0.0;
  // default voltage_power_supply
  motor.voltage_limit = 6;
  motor.voltage_sensor_align = 6;
  // jerk control using voltage voltage ramp
  // default value is 300 volts per sec  ~ 0.3V per millisecond
  motor.PID_velocity.output_ramp = 1000;

  // velocity low pass filtering time constant
  motor.LPF_velocity.Tf = 0.01f;


  motor.velocity_limit = 25;


  motor.P_angle.P = 12;
  motor.P_angle.I = 20;
  motor.P_angle.D = 0.0125;
  motor.P_angle.output_ramp = 1750;
  motor.LPF_angle.Tf = 0.01f;




  // motor.zero_electric_angle=3.74;
  // motor.sensor_direction=CW;
  motor.initFOC();


  encoder2.init();
  encoder2.enableInterrupts(doA2, doB2);
  motor2.linkSensor(&encoder2);

  driver2.voltage_power_supply = 12;
  driver2.init();
  motor2.linkDriver(&driver2);

  motor2.voltage_sensor_align = 8;
  motor2.voltage_limit = 10;
  // motor.voltage_power_supply = 12;

  motor2.controller = MotionControlType::angle;
  //  motor2.controller = MotionControlType::angle_openloop;
  motor2.foc_modulation = FOCModulationType::SinePWM;

  //  Velocity PID
  motor2.PID_velocity.P = 0.5;
  motor2.PID_velocity.I = 20;
  motor2.PID_velocity.D = 0.01;

  // jerk control using voltage voltage ramp
  // default value is 300 volts per sec  ~ 0.3V per millisecond11
  motor2.PID_velocity.output_ramp = 1000;
  // velocity low pass filtering time constant
  motor2.LPF_velocity.Tf = 0.01f;
  // velocity limit
  motor2.velocity_limit = 15;

  // angle PID
  motor2.P_angle.P = 20;
  // motor2.P_angle.I = 80;
  // motor2.P_angle.D = 0.003125f;
  motor2.P_angle.output_ramp = 1000;
  motor2.LPF_angle = 0.001f;


  // direction
  motor2.zero_electric_angle = 4.03;
  motor2.sensor_direction = CCW;

  motor2.useMonitoring(Serial);
  motor2.init();
  motor2.initFOC();



  // aduc motorul in pozitia 0
  int c1 = 500;
  while (c1) {
    motor.loopFOC();
    motor2.loopFOC();
    motor.move(0.0);
    motor2.move(0.0);
    c1--;
  }
  _delay(500);

  // incep comunicatia cu MPU6050
  // commands for motor 1
  command.add('p', doTarget_AP, "target ap");
  command.add('i', doTarget_AI, "target ai");
  command.add('d', doTarget_AD, "target ad");
  command.add('r', doTarget_Aramp, "target a ramp");
  command.add('P', doTarget_VP, "target vp");
  command.add('I', doTarget_VI, "target vi");
  command.add('D', doTarget_VD, "target vd");
  command.add('R', doTarget_Vramp, "targ v ramp");



  int c = 50;

  while (c > 0) {
    c--;
    mpu.update();
    Input_roll = mpu.getAngleX();
    Input_pitch = mpu.getAngleY();
    delay(20);
  }
  // calculez valoarea initiala
  mpu.update();
  Input_roll = mpu.getAngleX();
  Setpoint_roll = Input_roll;
  Input_pitch = mpu.getAngleX();
  Setpoint_pitch = Input_pitch;
  Serial.println(Setpoint_roll);
  Serial.println(Setpoint_pitch);
  motor.useMonitoring(Serial);
  Serial.println("Done!\n");
  pinMode(23, OUTPUT);
  digitalWrite(23, HIGH);
}

float target_angle_roll = 0.0;
float last_error_roll = 0.0;
float target_angle_pitch = 0.0;
float last_error_pitch = 0.0;
unsigned long timer = 0;
// double last_angle=0;
float max_move_roll = 0.7;
float max_move_pitch = 0.5;
float min_move_pitch = -0.4;
int ok = 0;

double error_roll = 0, error_pitch = 0;
float move_roll, move_pitch;

void loop() {

  motor.loopFOC();
  motor2.loopFOC();

  mpu.update();



  if ((millis() - timer > 15)) {
    if (abs(encoder.getVelocity()) < 4.5) {
      Input_roll = mpu.getAngleX();
      double enc_dif_roll = abs(target_angle_roll - encoder.getPreciseAngle());
      if (enc_dif_roll < 0.15) {
        error_roll = diff_roll(Input_roll);
        move_roll;
        if (error_roll != 0) {
          // move= -error/57.296; // 56
          move_roll = -error_roll / 57.2968;
        } else move_roll = 0.0;

        if (move_roll < -max_move_roll) move_roll = -max_move_roll;
        if (move_roll > max_move_roll) move_roll = max_move_roll;
        target_angle_roll += move_roll;
        if (target_angle_roll > max_move_roll) target_angle_roll = max_move_roll;
        if (target_angle_roll < -max_move_roll) target_angle_roll = -max_move_roll;

        // last_error_roll = error_roll;
        // last_angle=target_angle;
      }
      timer = millis();
    }
    if (abs(encoder2.getVelocity()) < 1) {
      // Serial.println("c");
      Input_pitch = mpu.getAngleY();
      double enc_dif_pitch = abs(target_angle_pitch - encoder2.getPreciseAngle());
      // Serial.print("Enc_dif:"); Serial.println(enc_dif_pitch);
      // if(enc_dif_pitch <= 0.2){
      error_pitch = diff_pitch(Input_pitch);
      float move_pitch;
      // //  if( abs( error - last_error) < 0.001)
      if (last_error_pitch != 0)
        error_pitch = 0;
      if (error_pitch != 0) {
        move_pitch = -error_pitch / 57.2968;  // 56.7 57.4
      }

      else move_pitch = 0.0;

      if (move_pitch < min_move_pitch) move_pitch = min_move_pitch;
      if (move_pitch > max_move_pitch) move_pitch = max_move_pitch;
      target_angle_pitch += move_pitch;
      if (target_angle_pitch > max_move_pitch) target_angle_pitch = max_move_pitch;
      if (target_angle_pitch < min_move_pitch) target_angle_pitch = min_move_pitch;
      //   Serial.print("Input:"); Serial.print(Input);Serial.println("");
      // Serial.print("Tg:"); Serial.print(target_angle_pitch);Serial.println("");
      Serial.print("ROLL:"); Serial.print(mpu.getAngleX());Serial.println("");
      last_error_pitch = error_pitch;
      // }
    }
  }
  motor.move(target_angle_roll);
  // motor.move(0.0);
  // motor2.move(target_angle_pitch);
  // motor2.move(0.0);


  // command.run();
}

double diff_roll(double x) {
  double dif = 0;

  dif = x - Setpoint_roll;

  if (dif < 0.8 && dif > -0.8)

    return 0;

  return dif;
}

double diff_pitch(double x) {
  double dif = 0;

  dif = x - Setpoint_pitch;
  
  if (dif < 0.5 && dif > -0.5)
    return 0;

  return dif;
}
