Ghinescu-Lucian/Licenta/Arduino/L298N/MotorSpin/MotorSpin.ino

int in1 = 9;
int in2 =10;
int in3 =11;

//int a;
int c;
int speed;

void setup() {
pinMode (in1 , OUTPUT);
pinMode (in2 , OUTPUT);
pinMode (in3, OUTPUT);
}

void loop() {
// for (int b=0; b<20;b++);
// {
//   digitalWrite(in1, HIGH);
//   delay(21);
//   digitalWrite(in1, LOW);

//   digitalWrite(in2, HIGH);
//   delay(21);
//   digitalWrite(in2, LOW);

//   digitalWrite(in3, HIGH);
//   delay(21);
//   digitalWrite(in3, LOW);
// }
// for (int b=0; b<20;b++);
// {
//   digitalWrite(in1, HIGH);
//   delay(18);
//   digitalWrite(in1, LOW);

//   digitalWrite(in2, HIGH);
//   delay(18);
//   digitalWrite(in2, LOW);

//   digitalWrite(in3, HIGH);
//   delay(18);
//   digitalWrite(in3, LOW);
// }
// for (int b=0; b<40;b++);
//   {
//   digitalWrite(in1, HIGH);
//   delay(16);
//   digitalWrite(in1, LOW);

//   digitalWrite(in2, HIGH);
//   delay(16);
//   digitalWrite(in2, LOW);

//   digitalWrite(in3, HIGH);
//   delay(16);
//   digitalWrite(in3, LOW);
//   }
//   for (int b=0; b<40;b++);
// {
//   digitalWrite(in1, HIGH);
//   delay(15);
//   digitalWrite(in1, LOW);

//   digitalWrite(in2, HIGH);
//   delay(15);
//   digitalWrite(in2, LOW);

//   digitalWrite(in3, HIGH);
//   delay(15);
//   digitalWrite(in3, LOW);
// }
//   for (int b=0; b<80;b++);
// {
//   digitalWrite(in1, HIGH);
//   delay(14);
//   digitalWrite(in1, LOW);

//   digitalWrite(in2, HIGH);
//   delay(14);
//   digitalWrite(in2, LOW);

//   digitalWrite(in3, HIGH);
//   delay(14);
//   digitalWrite(in3, LOW);
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
//   delay(3);
//   digitalWrite(in3, LOW);
// }

 speed =10;

while(c<100)
{
  
   
  digitalWrite(in1, HIGH);
  delay(speed);
  digitalWrite(in1, LOW);

  digitalWrite(in2, HIGH);
  delay(speed);
  digitalWrite(in2, LOW);

  digitalWrite(in3, HIGH);
  delay(speed);
  digitalWrite(in3, LOW);
}
}
