Ghinescu-Lucian/Licenta/Arduino/MPU6050/GetAngle/GetAngle.ino

/* Get tilt angles on X and Y, and rotation angle on Z
 * Angles are given in degrees
 * 
 * License: MIT
 */

#include "Wire.h"
#include <MPU6050_light.h>

MPU6050 mpu(Wire);
unsigned long timer = 0;

void setup() {
  Serial.begin(112500);
  Serial.println("Merge");
  Wire.begin();
  
  byte status = mpu.begin();
  Serial.print(F("MPU6050 status: "));
 Serial.println("CEVA");
  Serial.println(status);
  while(status!=0){
    Serial.println("CEVA");
   } // stop everything if could not connect to MPU6050
  
  Serial.println(F("Calculating offsets, do not move MPU6050"));
  delay(1000);
  // mpu.upsideDownMounting = true; // uncomment this line if the MPU6050 is mounted upside-down
  mpu.calcOffsets(); // gyro and accelero
  Serial.println("Done!\n");
}

void loop() {
  mpu.update();
  
  if((millis()-timer)>10){ // print data every 10ms
	Serial.print("X : ");
	Serial.print(mpu.getAngleX());
	Serial.print("\tY : ");
	Serial.print(mpu.getAngleY());
	Serial.print("\tZ : ");
	Serial.println(mpu.getAngleZ());
	timer = millis();  
  }
}
