Ghinescu-Lucian/Licenta/Arduino/MPU6050/TremorDetection/TremorDet/TremorDet.ino

// Basic demo for accelerometer readings from Adafruit MPU6050

#include <Adafruit_MPU6050.h>
#include <Adafruit_Sensor.h>
#include <Wire.h>

Adafruit_MPU6050 mpu;

void setup(void) {
  Serial.begin(115200);
  while (!Serial) {
    delay(10); // will pause Zero, Leonardo, etc until serial console opens
  }

  // Try to initialize!
  if (!mpu.begin()) {
    Serial.println("Failed to find MPU6050 chip");
    while (1) {
      delay(10);
    }
  }

  mpu.setAccelerometerRange(MPU6050_RANGE_16_G);
  mpu.setGyroRange(MPU6050_RANGE_250_DEG);
  mpu.setFilterBandwidth(MPU6050_BAND_21_HZ);
  Serial.println("");
  delay(100);
}

void loop() {

  /* Get new sensor events with the readings */
  sensors_event_t a, g, temp;
  mpu.getEvent(&a, &g, &temp);

  double accX = a .acceleration.x;
  double accY = a.acceleration.y;
  double accZ = a.acceleration.z;

  bool tremor=false;

  if(accY>0.01  || accX > -0.5 ||  (accZ <11 || accZ>12))
    tremor = true;
  
  if(tremor){
      Serial.print("I feel tremor: ");
      Serial.println(tremor);
      Serial.println(accX);
      Serial.println(accY);
      Serial.println(accZ);
  }

  // /* Print out the values */
  // Serial.print("AccelX:");
  // Serial.print(a.acceleration.x);
  // Serial.print(",");
  // Serial.print("AccelY:");
  // Serial.print(a.acceleration.y);
  // Serial.print(",");
  // Serial.print("AccelZ:");
  // Serial.print(a.acceleration.z);
  // Serial.print(", ");
  // Serial.print("GyroX:");
  // Serial.print(g.gyro.x);
  // Serial.print(",");
  // Serial.print("GyroY:");
  // Serial.print(g.gyro.y);
  // Serial.print(",");
  // Serial.print("GyroZ:");
  // Serial.print(g.gyro.z);
  // Serial.println("");

  // delay(10);
}
