Ghinescu-Lucian/Licenta/Arduino/PID/PID ex/PID ex.ino

#include <PID_v1.h>

double Setpoint, Input, Output;

// PID control variables
double Kp = 0.2, Ki = 0.01, Kd = 0.1;
PID myPID(&Input, &Output, &Setpoint, Kp, Ki, Kd, DIRECT);

void setup() {
  Input = analogRead(A0);  // Read the initial position of the sensor
  Setpoint = Input;        // Set the target position of the sensor
  myPID.SetMode(AUTOMATIC);
  myPID.SetSampleTime(100);
}

void loop() {
  Input = analogRead(A0);  // Read the current position of the sensor
  myPID.Compute();         // Calculate the control output using the PID algorithm
  // Use the control output to control the position of the sensor
  // ...
}
