Ghinescu-Lucian/Licenta/(commit log)

2023-05-24 Licenta stadiu 1
    [GradeEroare.xlsx]
2023-06-01 Licenta stadiu intermediar
    [AMT103V.fzz, MPU-6050 Board GY-521 Acelerometro Giroscopio.fzz]
2023-06-10 Intermediar stage of documentation
2023-06-14 Final adjustments
    [Masuratori-Test2.xlsx, Masuratori_Test1.xlsx]
